GuzziFlipFlops/ESP32/Assets/PTT home screen GUI.png

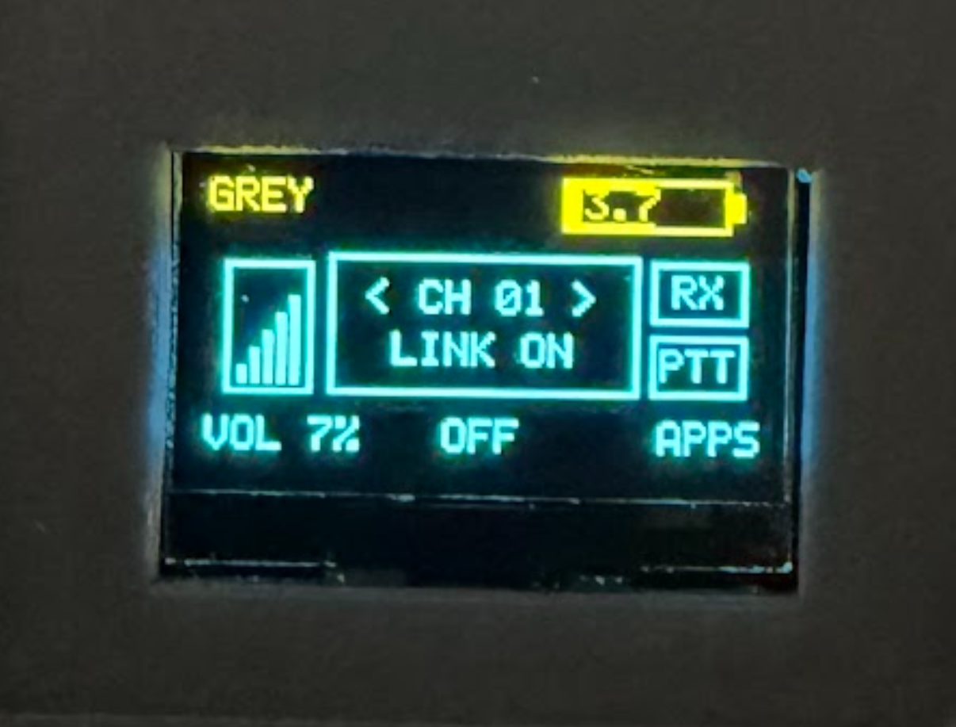
Assets/PTT home screen GUI.png
