GuzziFlipFlops/ESP32/Assets/LIGHT STROBE GUI.png

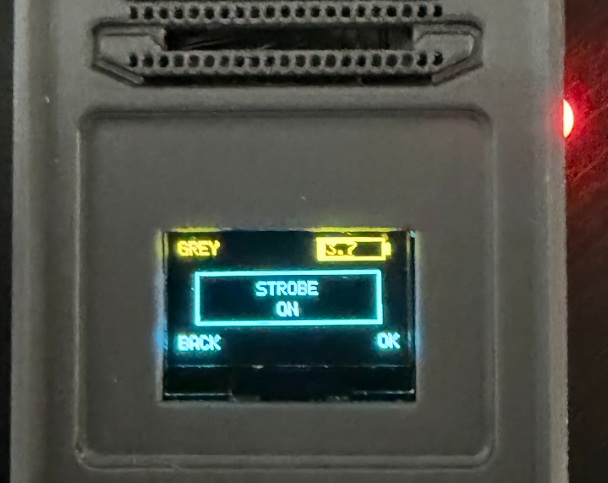
Assets/LIGHT STROBE GUI.png
