GuzziFlipFlops/ESP32/Assets/Increase MIC sense settings GUI.png

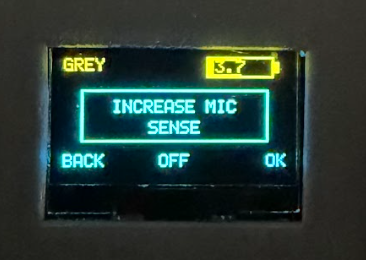
Assets/Increase MIC sense settings GUI.png
