GuzziFlipFlops/ESP32/Assets/readme/black-walkie-internal.jpg

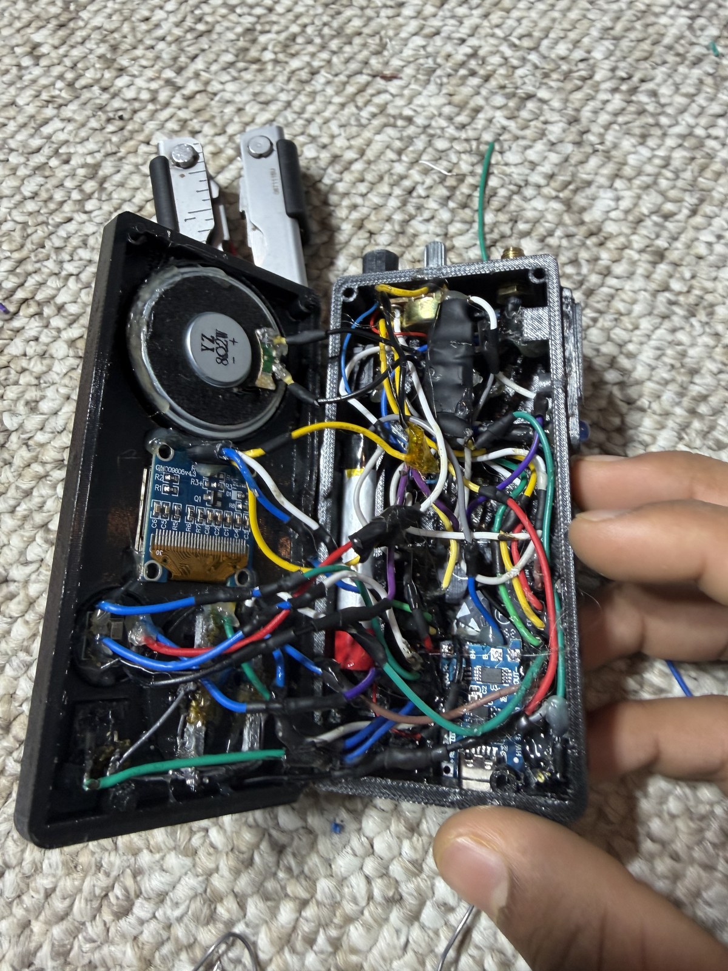
Assets/readme/black-walkie-internal.jpg
