GuzziFlipFlops/ESP32/Assets/readme/black-walkie-only.jpg

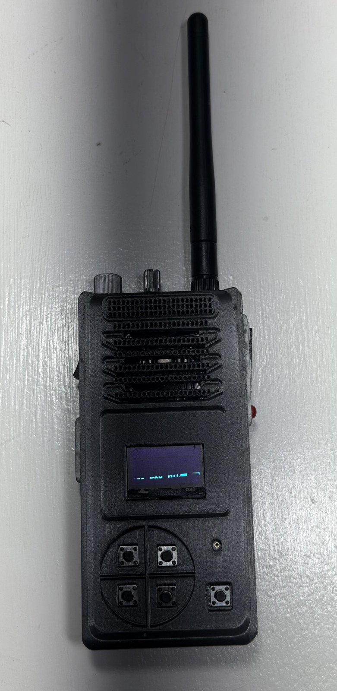
Assets/readme/black-walkie-only.jpg
