GuzziFlipFlops/ESP32/Assets/readme/both-walkies-main.jpg

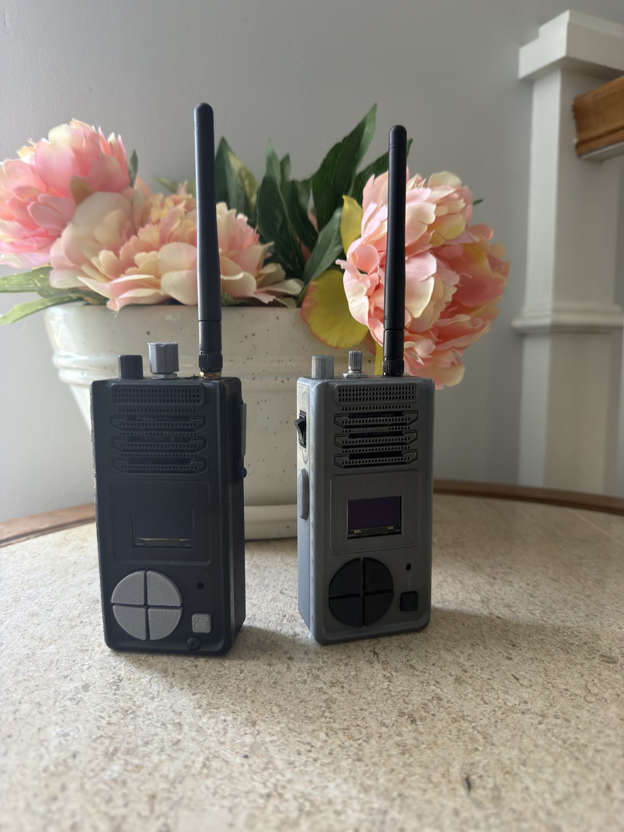
Assets/readme/both-walkies-main.jpg
