GuzziFlipFlops/ESP32/Assets/readme/both-walkies-second.jpg

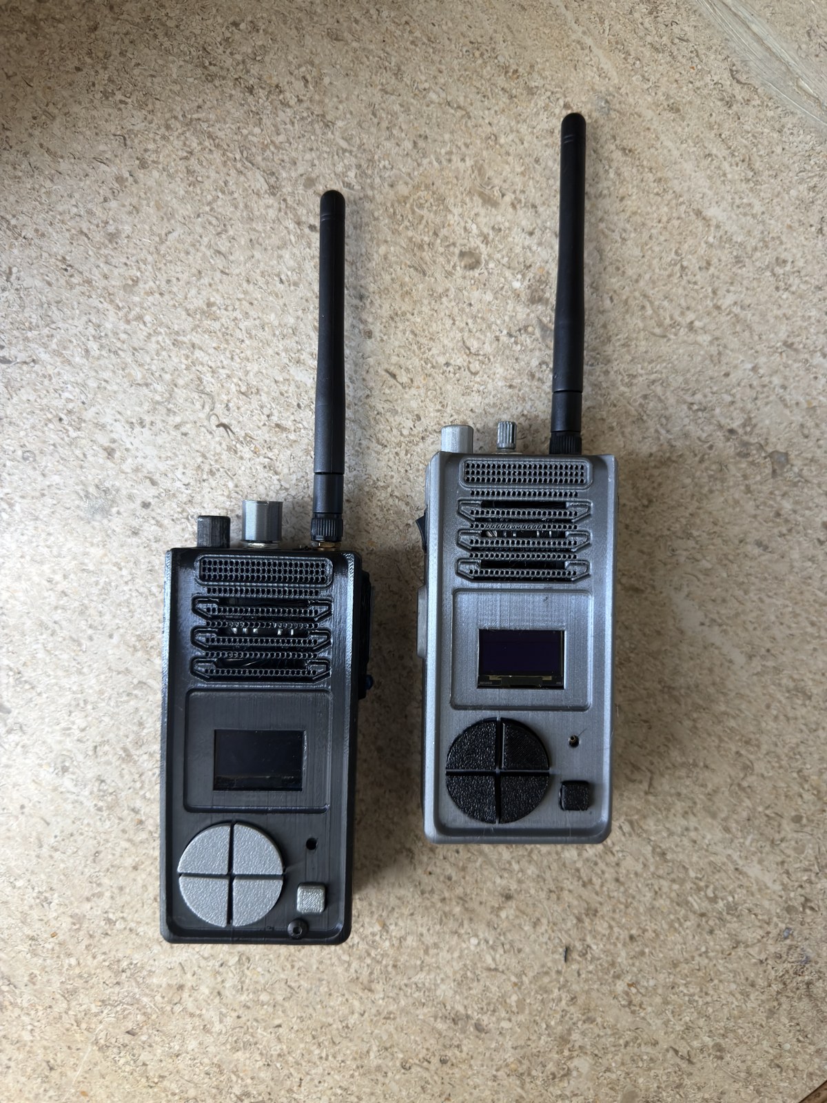
Assets/readme/both-walkies-second.jpg
