GuzziFlipFlops/ESP32/Assets/readme/grey-walkie-internal.jpg

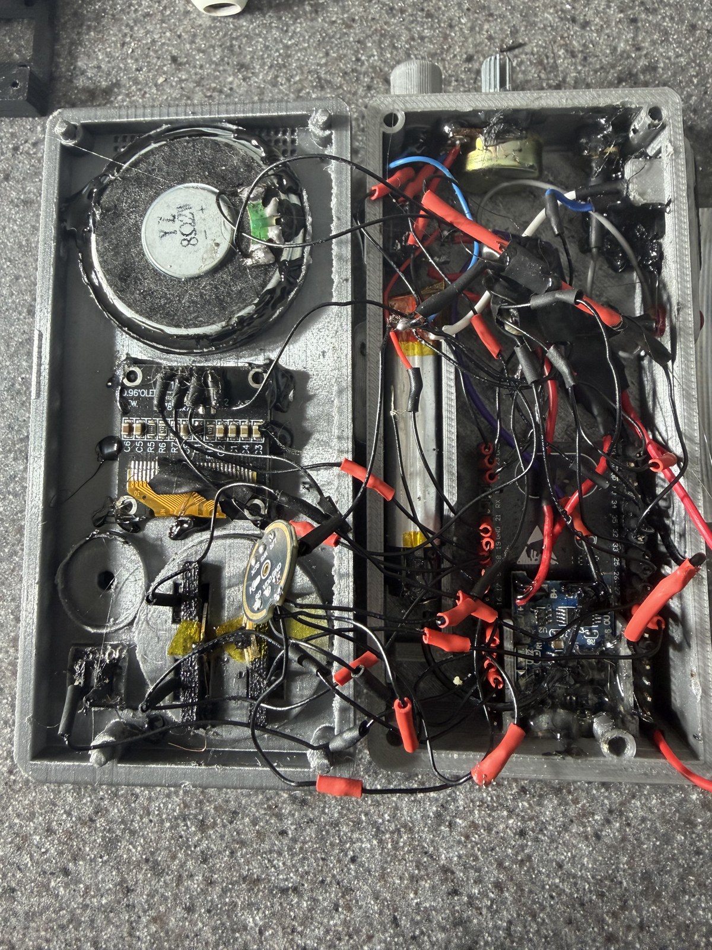
Assets/readme/grey-walkie-internal.jpg
