GuzziFlipFlops/ESP32/Assets/readme/grey-walkie-only.jpg

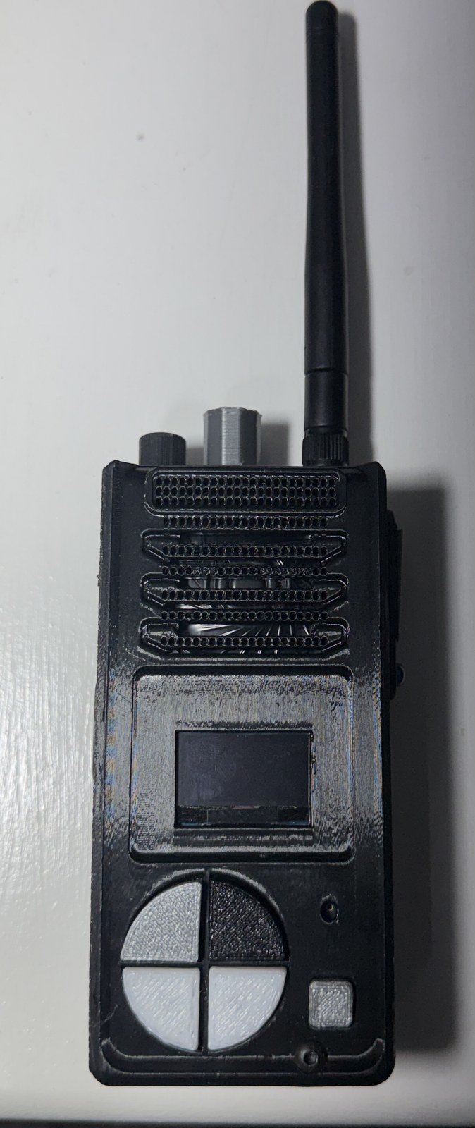
Assets/readme/grey-walkie-only.jpg
