GuzziFlipFlops/ESP32/Assets/SCANNING CHANNEL GUI.png

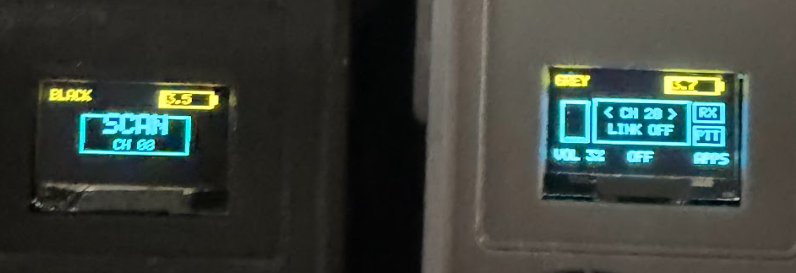
Assets/SCANNING CHANNEL GUI.png
