GuzziFlipFlops/ESP32/Assets/Walkie Talkie Circuit Diagram.png

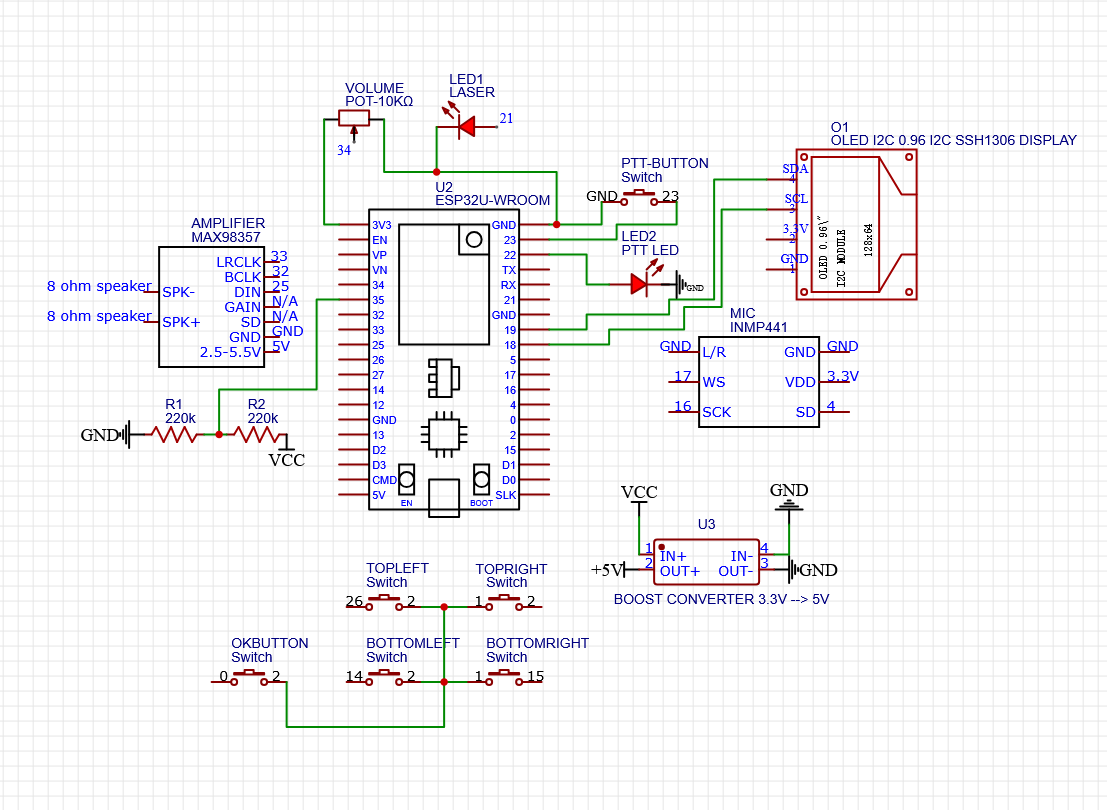
Assets/Walkie Talkie Circuit Diagram.png
