GuzziFlipFlops/ESP32/Walkie Talkie CAD files/walkie_talkie_PTT_button.stl

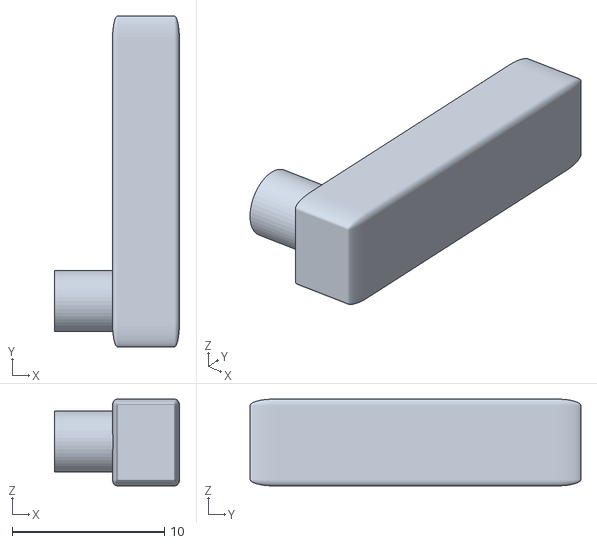
[picture p12: CAD file, 2026-04-10]
Walkie Talkie CAD files/walkie_talkie_PTT_button.stl
8.20 x 21.7 x 5.70
