GuzziFlipFlops/ESP32/Walkie Talkie CAD files/walkie_talkie_bottom_case.stl

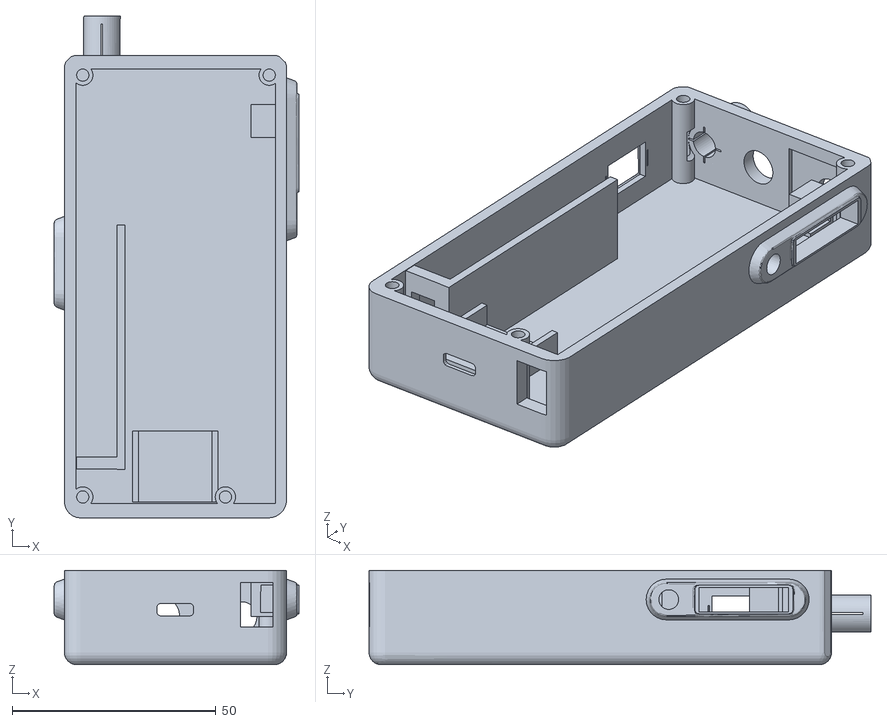
[picture p13: CAD file, 2026-04-10]
Walkie Talkie CAD files/walkie_talkie_bottom_case.stl
60.0 x 123.2 x 23.2
