GuzziFlipFlops/ESP32/Walkie Talkie CAD files/walkie_talkie_top_cover.stl

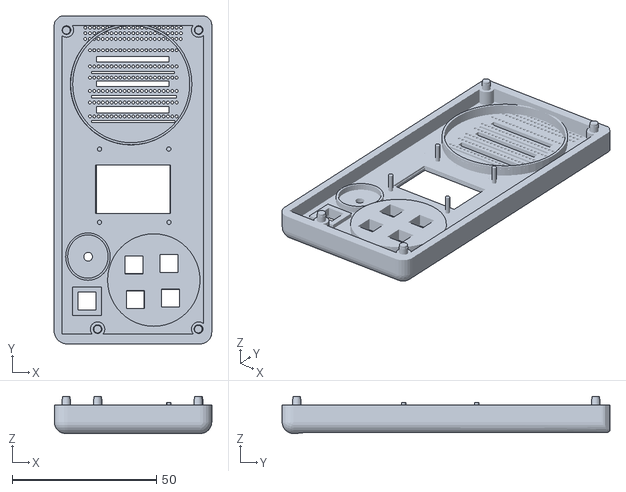
[picture p14: CAD file, 2026-04-10]
Walkie Talkie CAD files/walkie_talkie_top_cover.stl
54.5 x 113.5 x 12.8
