GuzziFlipFlops/ESP32/Walkie Talkie CAD files/walkie_talkie_PTT_button_insert.stl

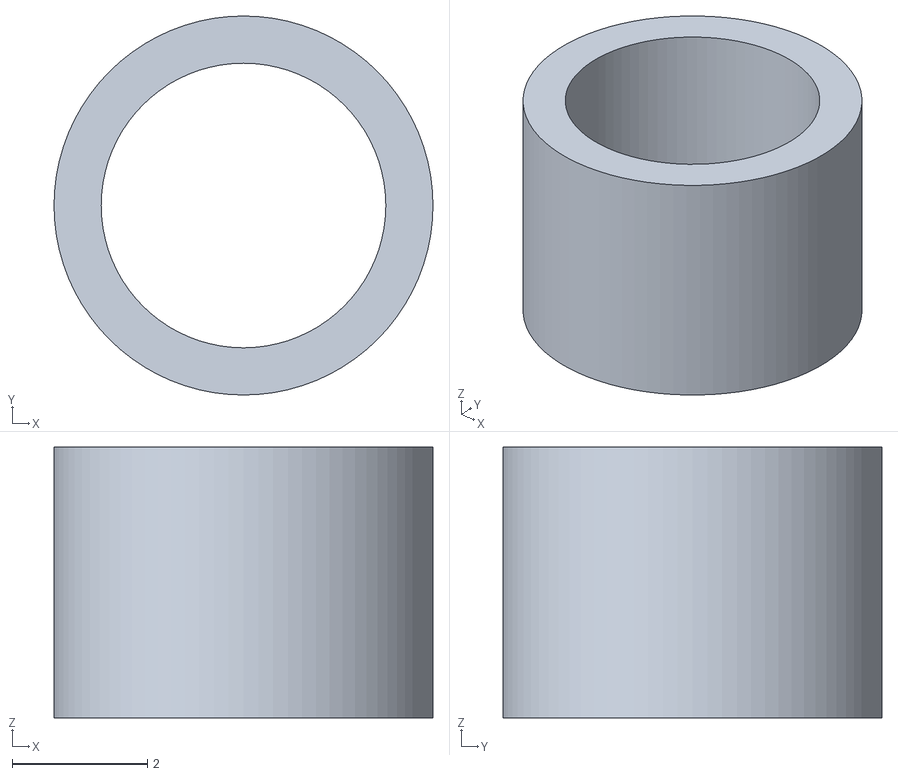
[picture p15: CAD file, 2026-04-10]
Walkie Talkie CAD files/walkie_talkie_PTT_button_insert.stl
5.60 x 5.60 x 4.00
