GuzziFlipFlops/ESP32/Walkie Talkie CAD files/walkie_talkie_top_buttons_grid.stl

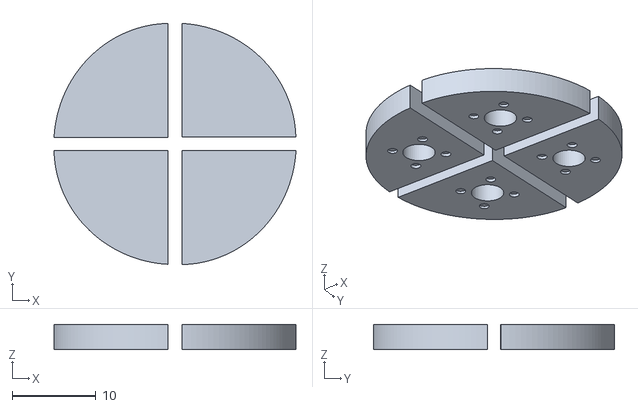
[picture p16: CAD file, 2026-04-10]
Walkie Talkie CAD files/walkie_talkie_top_buttons_grid.stl
29.0 x 28.9 x 3.00
