GuzziFlipFlops/ESP32/Walkie Talkie CAD files/walkie_talkie_OK_button.stl

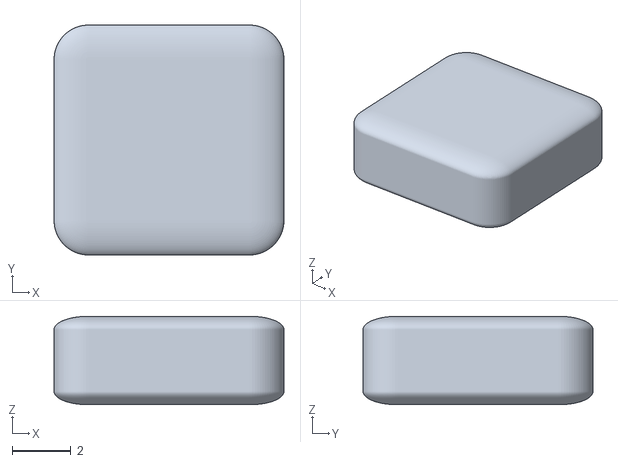
[picture p17: CAD file, 2026-04-10]
Walkie Talkie CAD files/walkie_talkie_OK_button.stl
7.80 x 7.80 x 3.00
