GuzziFlipFlops/ESP32/(commit log)

2026-04-10 walkie talkie done
    [walkie_talkie_OK_button.stl, walkie_talkie_PTT_button.stl, walkie_talkie_PTT_button_insert.stl, walkie_talkie_bottom_case.stl, walkie_talkie_top_buttons_grid.stl, walkie_talkie_top_cover.stl]
2026-04-11 gui addded
    [partitions.csv]
2026-06-28 Revise README for clarity and conciseness
    Removed unnecessary details about battery sourcing and clarified firmware features and planned ideas.
